alex-kozin/meclimate/program/help/part3.files/image008.jpg

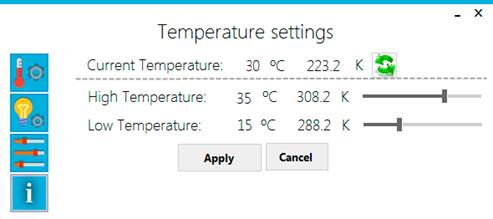
program/help/part3.files/image008.jpg
