alex-kozin/meclimate/readme.txt

Work has originally been presented in Ukrainian, English translation to follow.

Автор: Козін Олександр Андрійович

Керівник: Олінович Юлія Миколаївна

Тема роботи: Створення автономного пристрою регуляції температури та освітленості в приміщенні

Анотація: Метою роботи була розробка автономного пристрою MeClimate, що здатен регулювати температуру та освітленість
у приміщенні (квартирі, будинку, в офісі і таке інше).Актуальність моєї роботи полягає у факті, що схожі за функціональністю
пристрої набирають популярності серед широкого кола користувачів. Результатом роботи є апаратний продукт – пристрій MeClimate,
що є основною частиною, а також не менший за обсягом виконаної роботи та витраченого часу програмний продукт – програма-клієнт
MeClimate.exe, що дозволяє налаштувати автономний пристрій регуляції температури та освітленості.

Мови програмування: Wired(C) - компілятор avr-gcc v.4.8.1 та С# - компілятор csc v.4.6

Апаратні вимоги: 
		  •	Процесор: 2.0+ GHz dual core processor;
		  •	Оперативна пам’ять: 2 GB ОЗУ;
		  •	Відеокарта: Radeon HD2000 series or higher, GeForce 8000 series or higher, minimum 256MB dedicated memory;
		  •	Монітор;
		  •	Простір на диску:  40 MB;
		  •	Wi-Fi адаптер;
		  •	Комп’ютерна миша або інший пристрій введення.

Програмні вимоги: •	ОС: Windows XP або старша;
		  •	.NET: Версії 4.5 або вище;
		  •	VisualBasic PowerPacks v.10.0;

Файл запуску програми: MeClimate.exe

Програма не потребує установки.

Програма використовує файли бібліотек MetroFramework.Design.dll, MetroFramework.dll, MetroFramework.Fonts.dll,
Microsoft.VisualBasic.PowerPacks.dll, SimpleWifi.dll, а також файли з папки help як посібник користувача

Особливості роботи з програмою зазначено у посібнику користувача.
