alex-kozin/meclimate/program/help/part3.files/image003.png

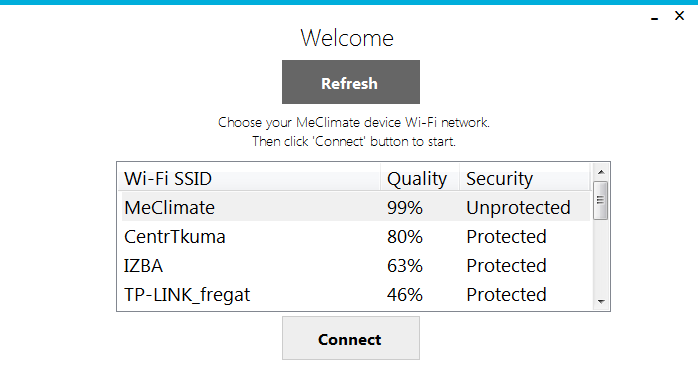
program/help/part3.files/image003.png
