alex-kozin/meclimate/program/help/part3.files/image006.jpg

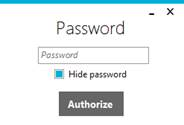
program/help/part3.files/image006.jpg
