alex-kozin/meclimate/program/help/part4.files/image002.jpg

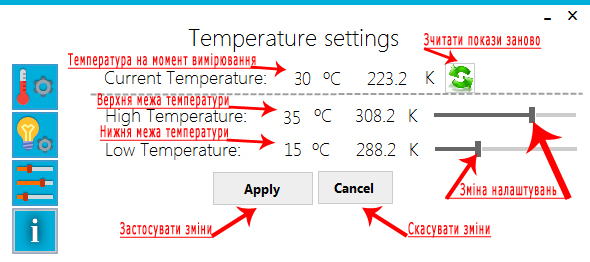
program/help/part4.files/image002.jpg
