alex-kozin/meclimate/program/help/part4.files/image004.jpg

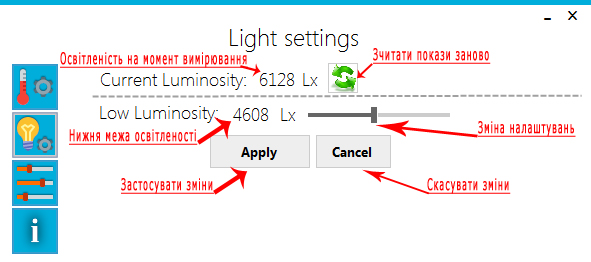
program/help/part4.files/image004.jpg
