alex-kozin/meclimate/program/help/part4.files/image006.jpg

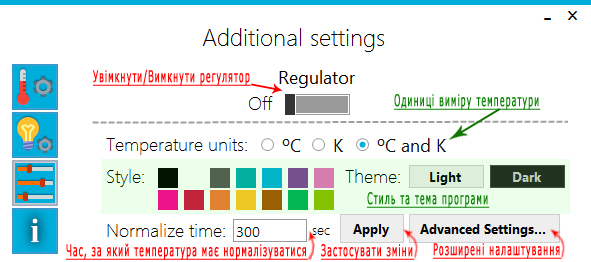
program/help/part4.files/image006.jpg
