alex-kozin/meclimate/program/help/part4.files/image007.png

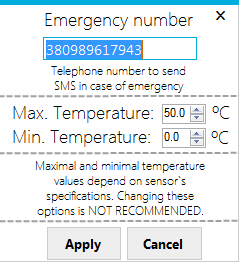
program/help/part4.files/image007.png
